ayush9pandey/loadCell/loadCell_final.jpg

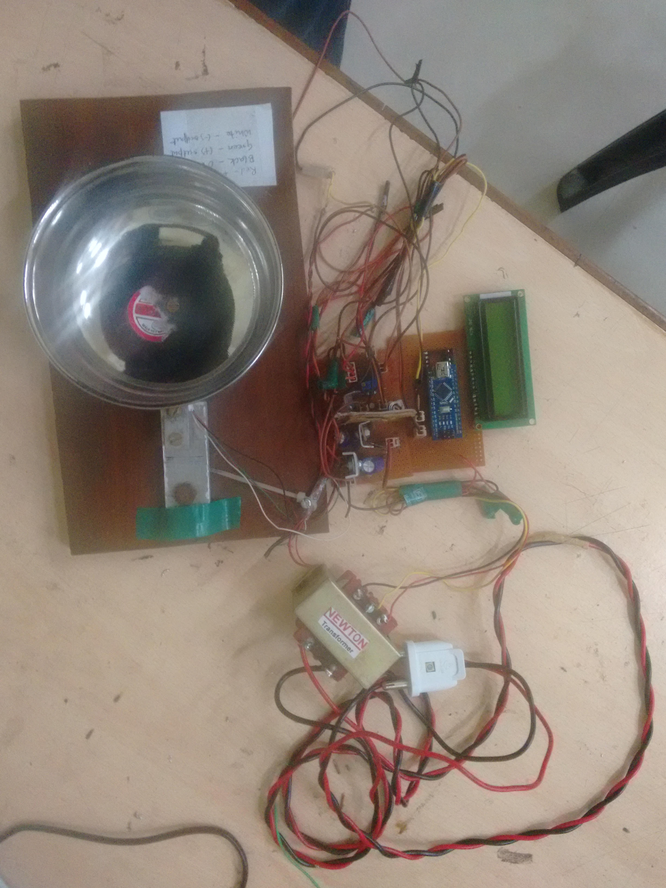
loadCell_final.jpg
