ayush9pandey/loadCell/README.md

<h> <b> Instrumentation System Design of a Load Cell </b> <br>
Signal Conditioning and Data Processing <br>
Weight Display on LCD <br>

Under the Guidance of Prof. Karabi Biswas, IIT Kharagpur <br>
