ayush9pandey/loadCell/(commit log)

2015-09-01 Initial Commit, ADC code completed
2015-11-28 The project has been completed, the video is on my youtube channel. The final report has been completed as well and is being committed now. The filtering code, though is not perfect, works ok. Some i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
